n0tRoshan/Micromouse/assets/beam_vs_wall.png

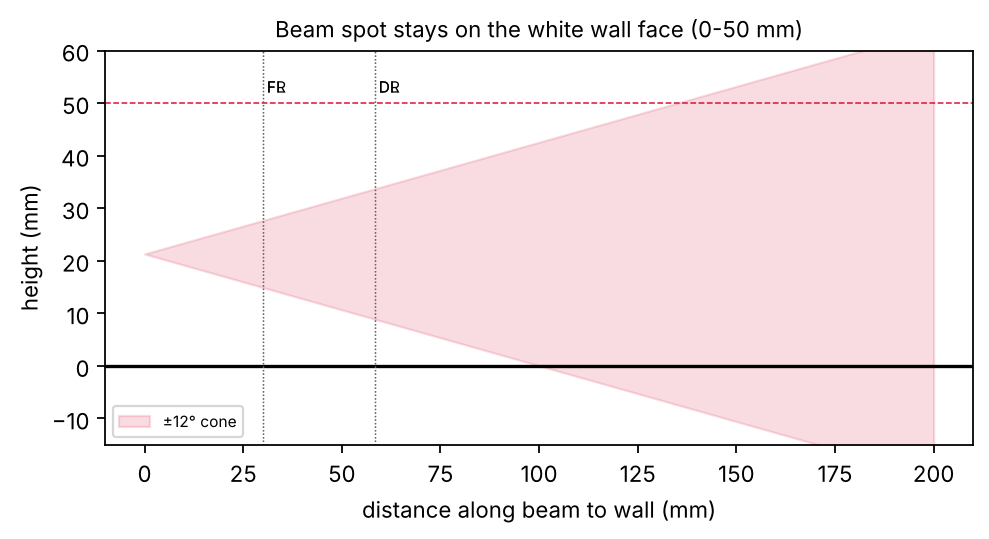
assets/beam_vs_wall.png
