n0tRoshan/Micromouse/assets/drawing_front.png

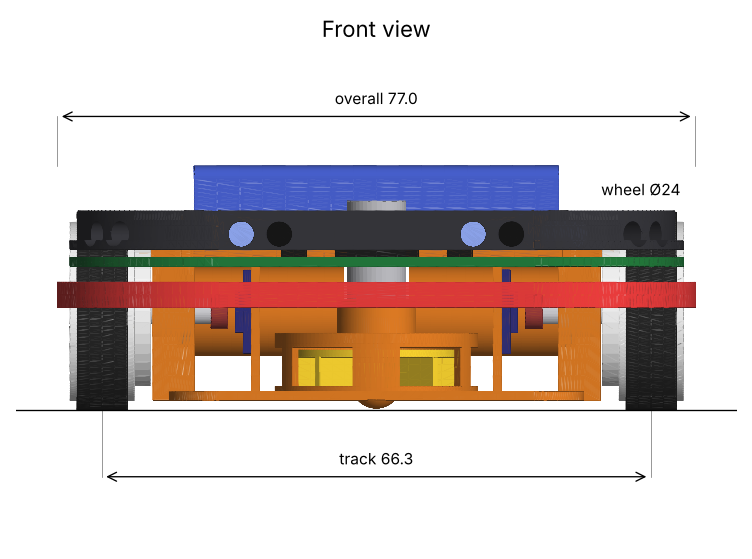
assets/drawing_front.png
