n0tRoshan/Micromouse/assets/drawing_side.png

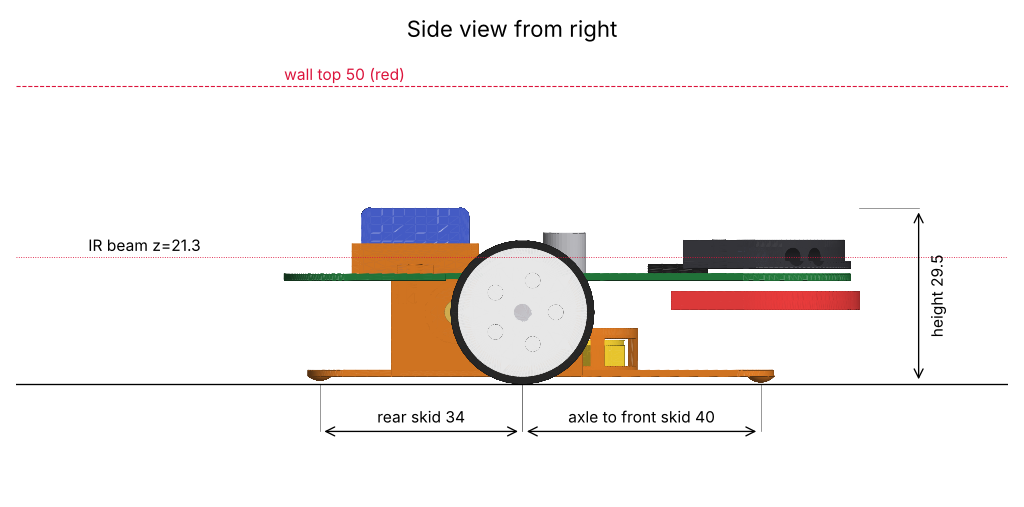
assets/drawing_side.png
