n0tRoshan/Micromouse/assets/iso_rear_right.png

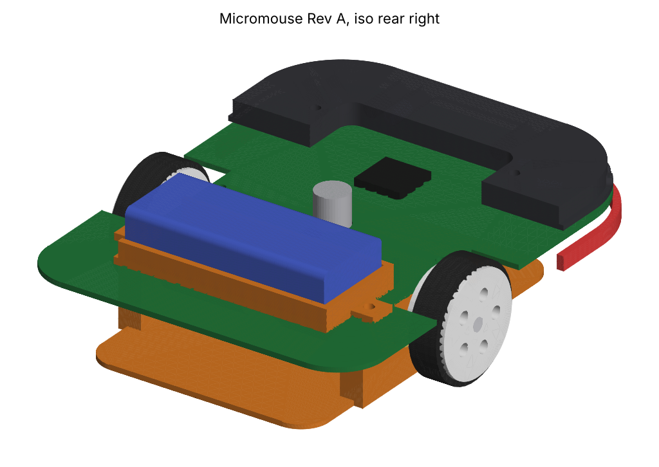
assets/iso_rear_right.png
