n0tRoshan/Micromouse/cad_design/step/micromouse_revA_assembly.step

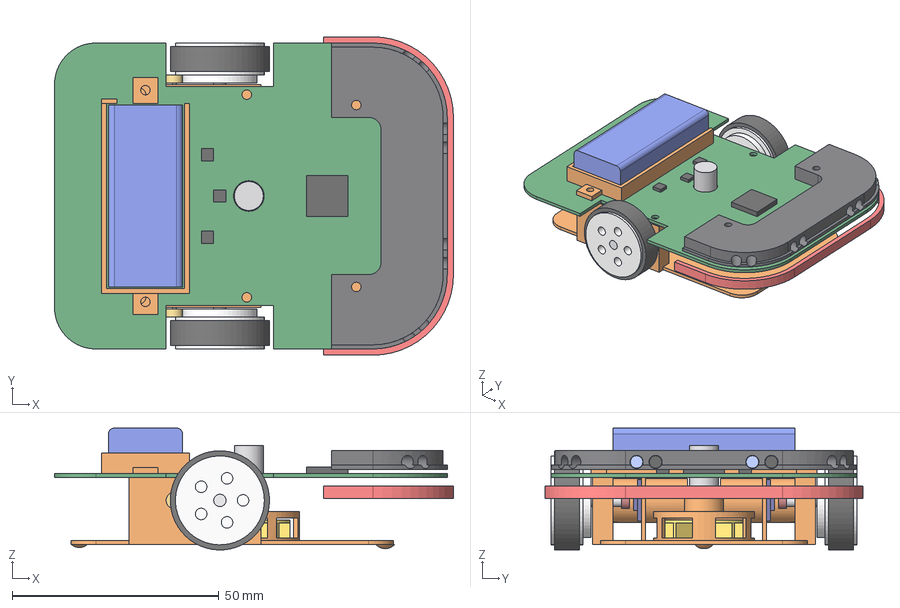
[picture p11: CAD file, 2026-10-19]
cad_design/step/micromouse_revA_assembly.step
96.5 x 77.0 x 29.5 mm
frame
plate
motor_L
pinion_L
spur_L
bearings_L
axle_L
hub_L
tire_L
magnet_L
encoder_L
motor_R
pinion_R
spur_R
bearings_R
axle_R
hub_R
tire_R
magnet_R
encoder_R
impeller
fan_motor
sensor_block
ir_emitters
ir_receivers
battery_holder
battery
bumper
mcu
imu
motor_driver
fan_mosfet
