n0tRoshan/Micromouse/cad_design/step/pinion_R.step

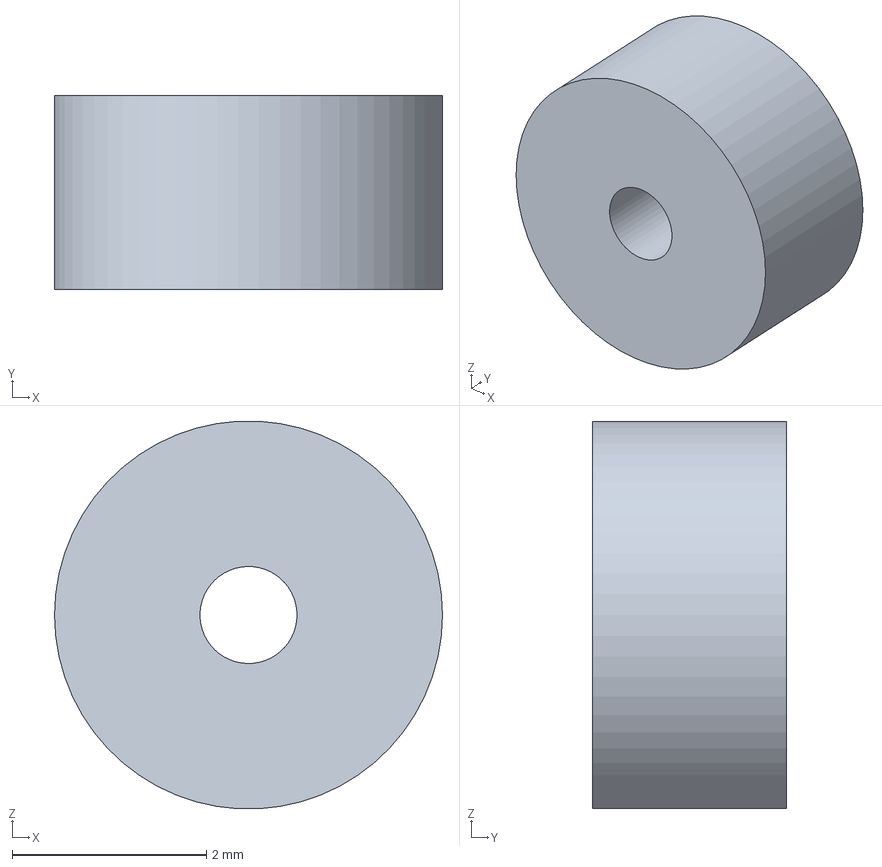
[picture p12: CAD file, 2026-10-19]
cad_design/step/pinion_R.step
4.00 x 2.00 x 3.99 mm
