n0tRoshan/Micromouse/cad_design/step/encoder_L.step

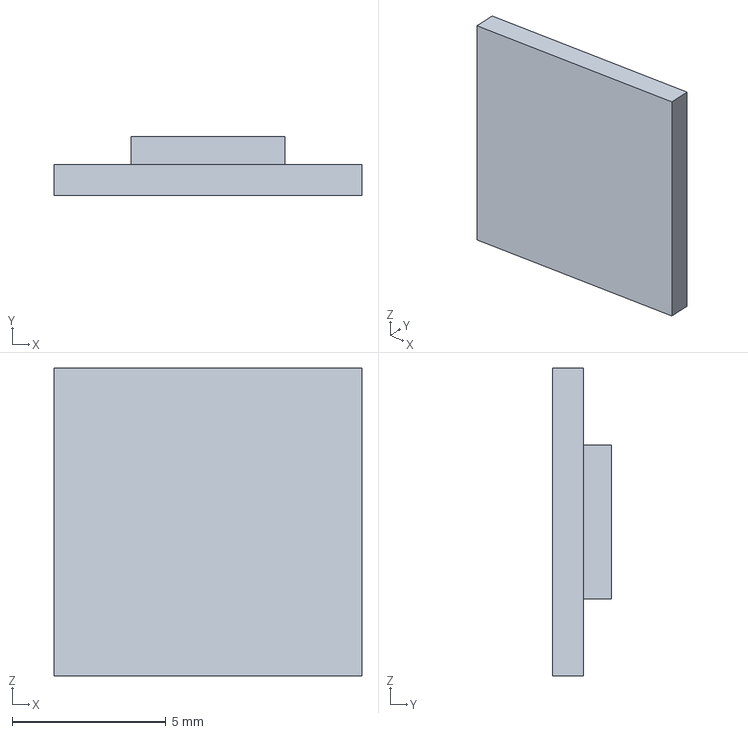
[picture p13: CAD file, 2026-10-19]
cad_design/step/encoder_L.step
10.0 x 1.90 x 10.0 mm
