n0tRoshan/Micromouse/cad_design/step/plate.step

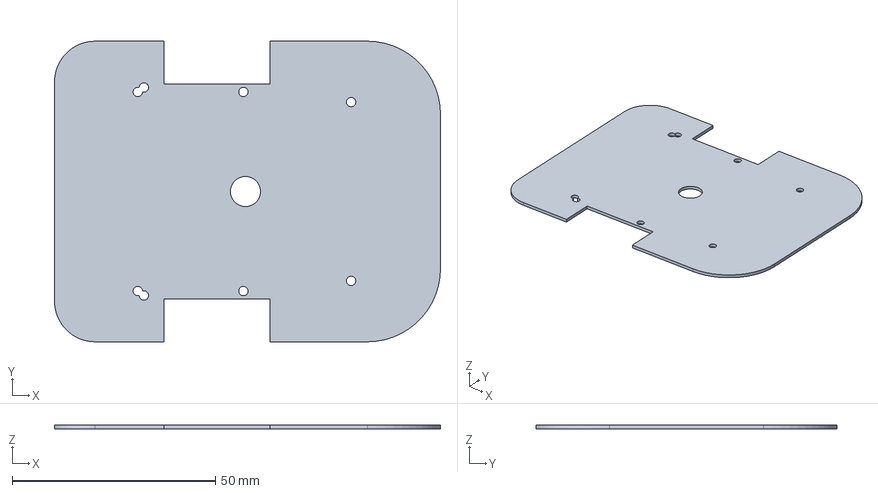
[picture p14: CAD file, 2026-10-19]
cad_design/step/plate.step
95.0 x 74.0 x 1.00 mm
