n0tRoshan/Micromouse/cad_design/step/spur_R.step

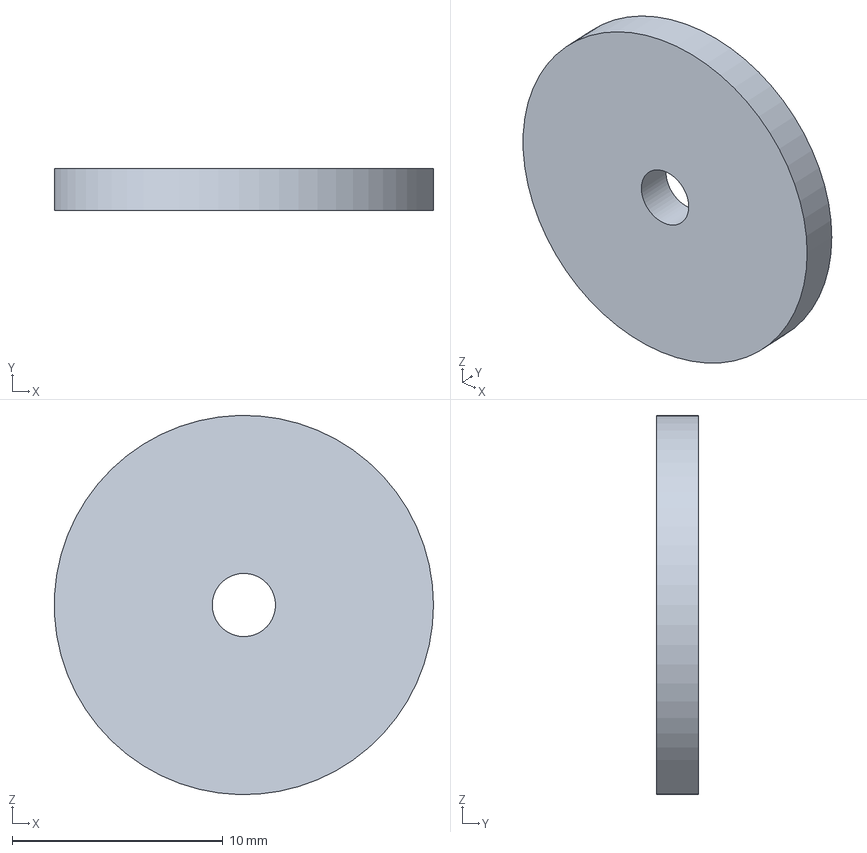
[picture p15: CAD file, 2026-10-19]
cad_design/step/spur_R.step
18.0 x 2.00 x 18.0 mm
