n0tRoshan/Micromouse/cad_design/step/mcu.step

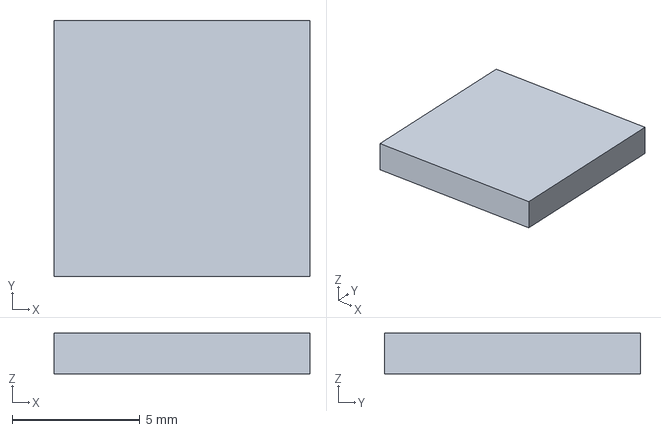
[picture p16: CAD file, 2026-10-19]
cad_design/step/mcu.step
10.0 x 10.0 x 1.60 mm
