n0tRoshan/Micromouse/cad_design/step/fan_mosfet.step

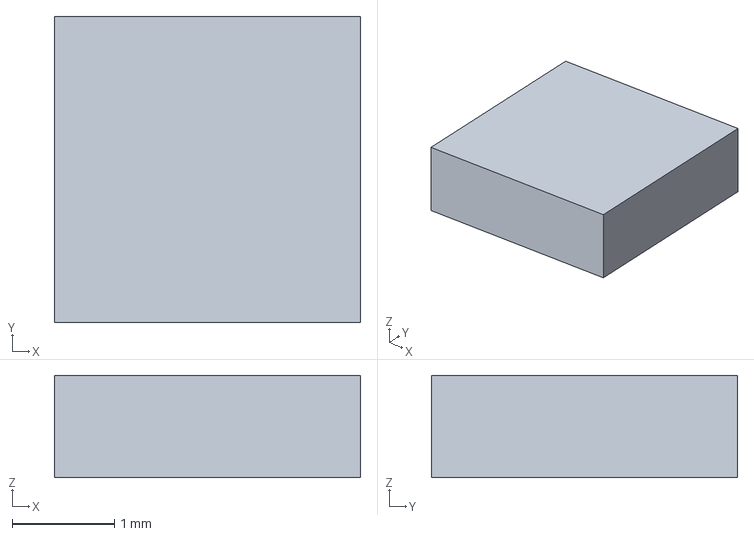
[picture p17: CAD file, 2026-10-19]
cad_design/step/fan_mosfet.step
3.00 x 3.00 x 1.00 mm
