n0tRoshan/Micromouse/cad_design/step/sensor_block.step

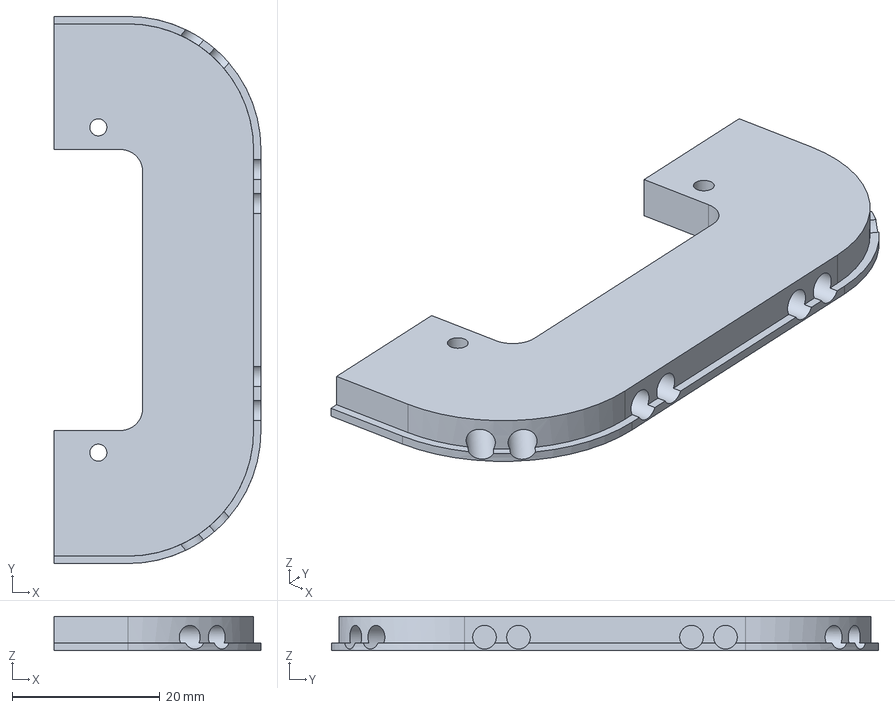
[picture p18: CAD file, 2026-10-19]
cad_design/step/sensor_block.step
28.0 x 74.0 x 4.60 mm
