n0tRoshan/Micromouse/cad_design/step/motor_L.step

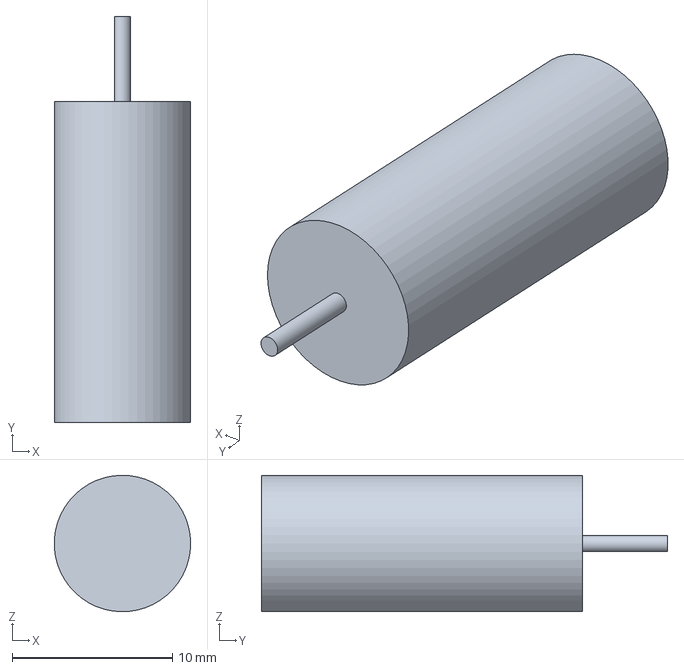
[picture p19: CAD file, 2026-10-19]
cad_design/step/motor_L.step
8.49 x 25.3 x 8.50 mm
