n0tRoshan/Micromouse/cad_design/step/fan_motor.step

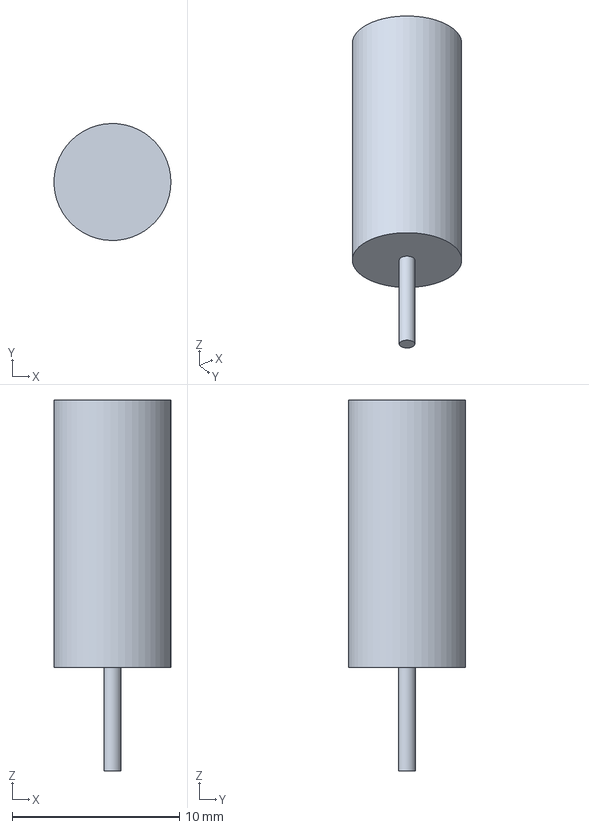
[picture p20: CAD file, 2026-10-19]
cad_design/step/fan_motor.step
6.99 x 7.00 x 22.2 mm
