n0tRoshan/Micromouse/cad_design/step/tire_L.step

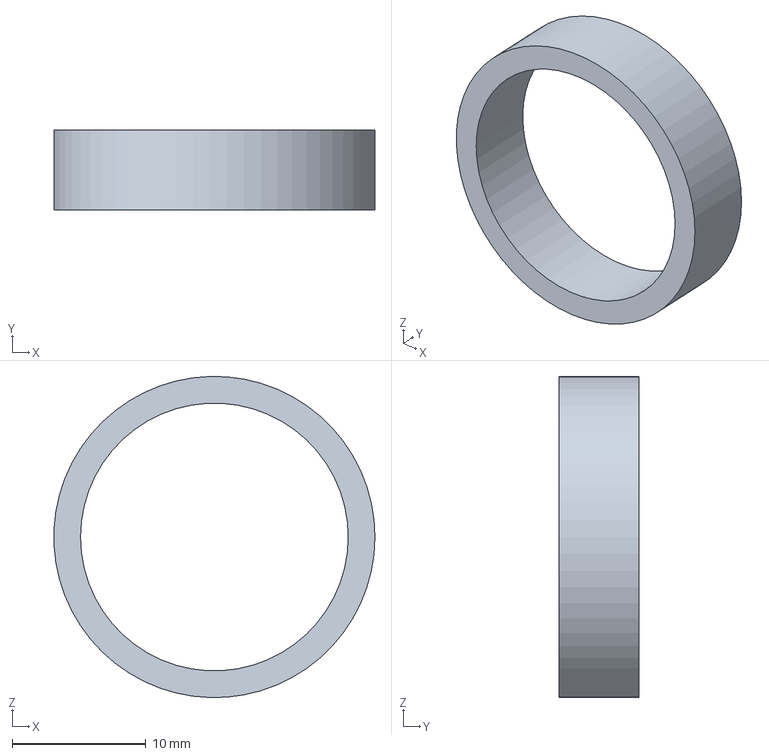
[picture p21: CAD file, 2026-10-19]
cad_design/step/tire_L.step
24.0 x 6.00 x 24.0 mm
