n0tRoshan/Micromouse/cad_design/step/bearings_L.step

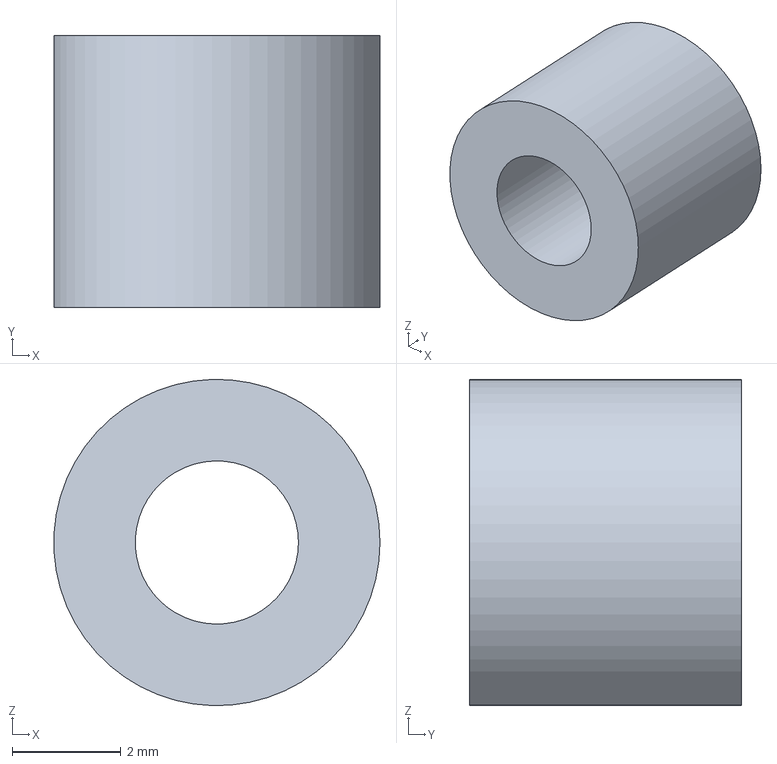
[picture p22: CAD file, 2026-10-19]
cad_design/step/bearings_L.step
6.00 x 5.00 x 6.00 mm
