n0tRoshan/Micromouse/cad_design/step/magnet_R.step

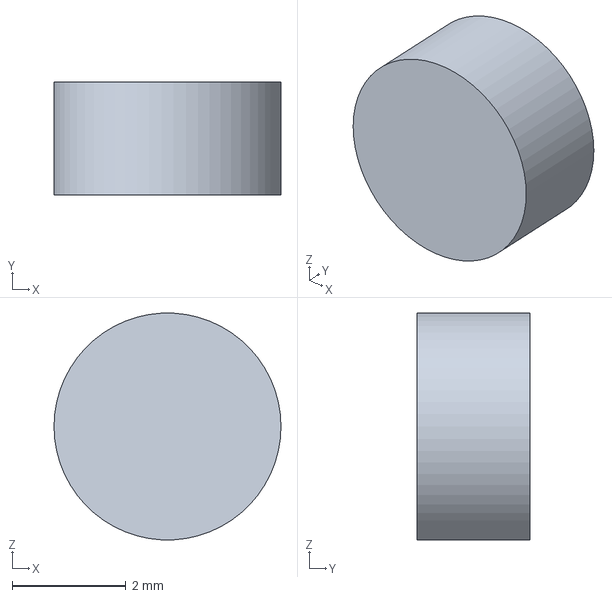
[picture p23: CAD file, 2026-10-19]
cad_design/step/magnet_R.step
4.00 x 2.00 x 3.99 mm
