n0tRoshan/Micromouse/cad_design/step/frame.step

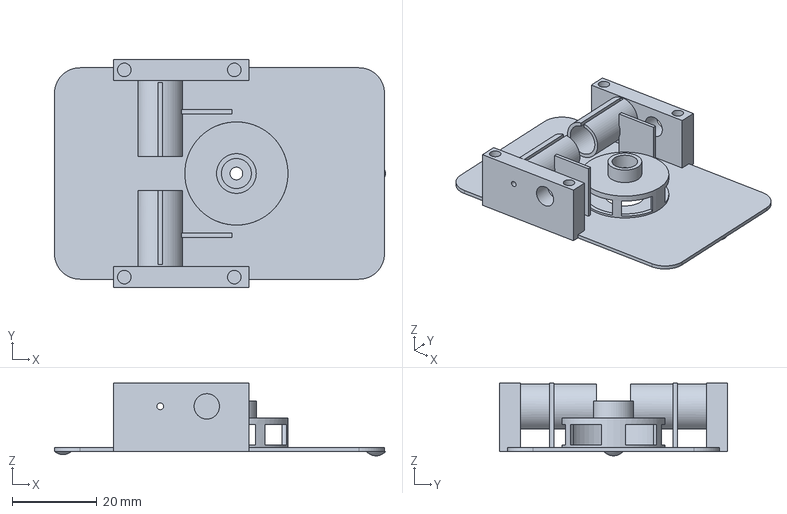
[picture p24: CAD file, 2026-10-19]
cad_design/step/frame.step
78.2 x 54.0 x 17.2 mm
