n0tRoshan/Micromouse/cad_design/step/impeller.step

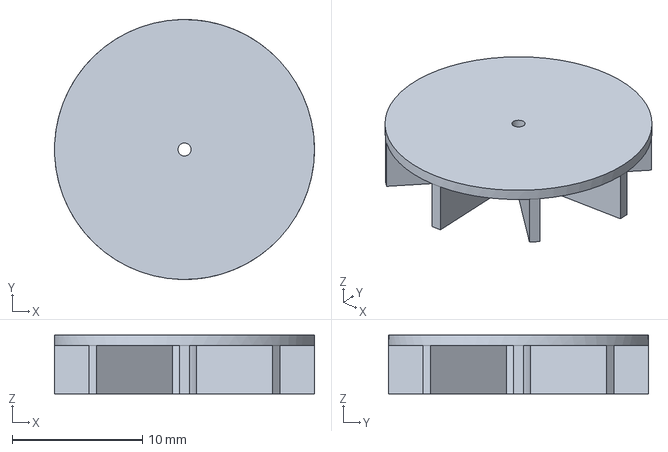
[picture p25: CAD file, 2026-10-19]
cad_design/step/impeller.step
20.0 x 20.0 x 4.50 mm
