n0tRoshan/Micromouse/cad_design/step/ir_receivers.step

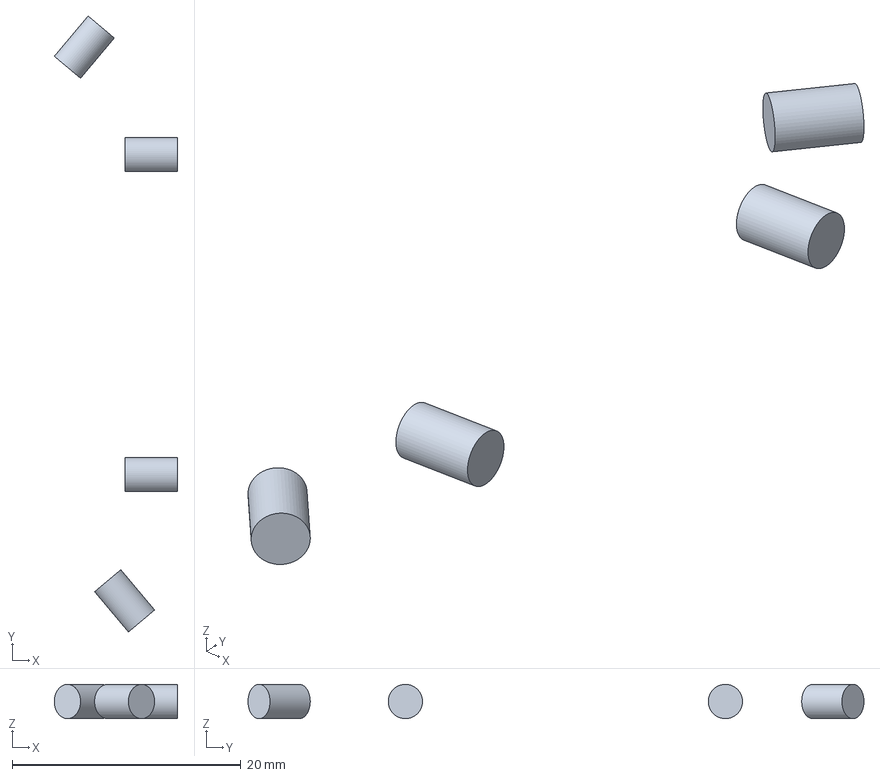
[picture p26: CAD file, 2026-10-19]
cad_design/step/ir_receivers.step
10.8 x 53.9 x 3.00 mm
