n0tRoshan/Micromouse/cad_design/step/axle_L.step

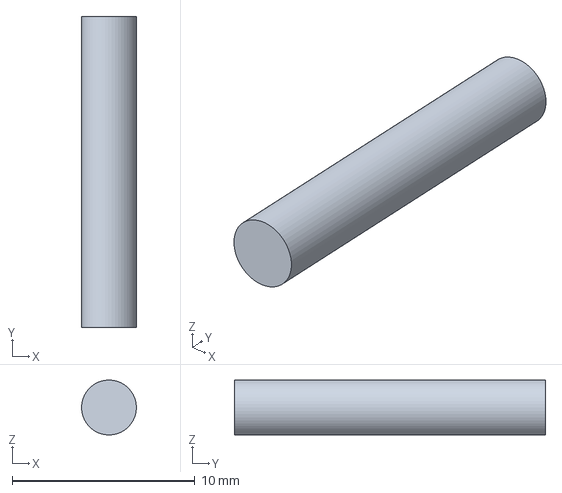
[picture p27: CAD file, 2026-10-19]
cad_design/step/axle_L.step
3.00 x 17.0 x 3.00 mm
