n0tRoshan/Micromouse/cad_design/step/hub_L.step

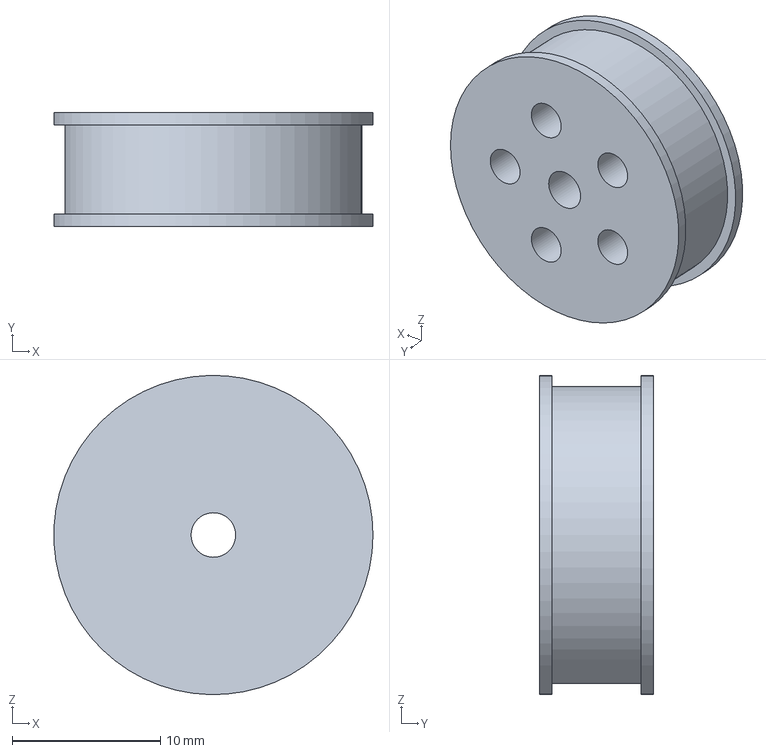
[picture p28: CAD file, 2026-10-19]
cad_design/step/hub_L.step
21.5 x 7.70 x 21.5 mm
