n0tRoshan/Micromouse/cad_design/step/battery.step

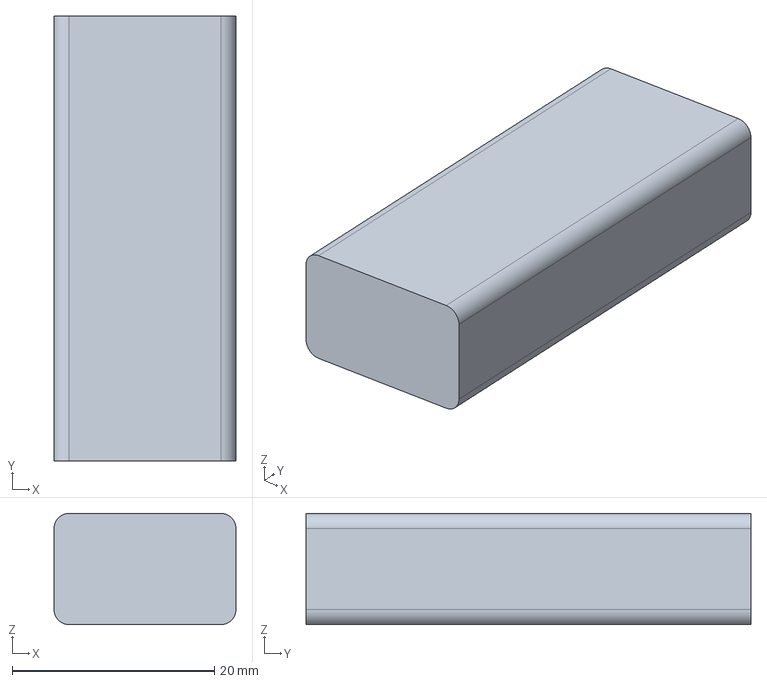
[picture p29: CAD file, 2026-10-19]
cad_design/step/battery.step
18.0 x 44.0 x 11.0 mm
