n0tRoshan/Micromouse/cad_design/step/plate_outline.dxf

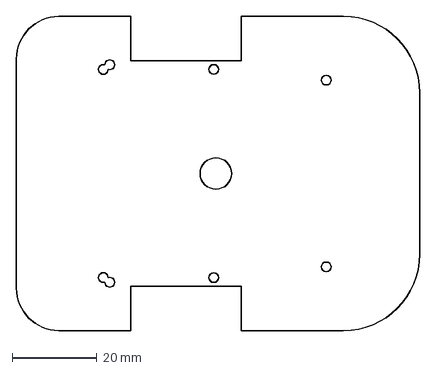
[picture p30: CAD file, 2026-10-19]
cad_design/step/plate_outline.dxf
95.0 x 74.0 mm
