n0tRoshan/Micromouse/cad_design/step/bumper.step

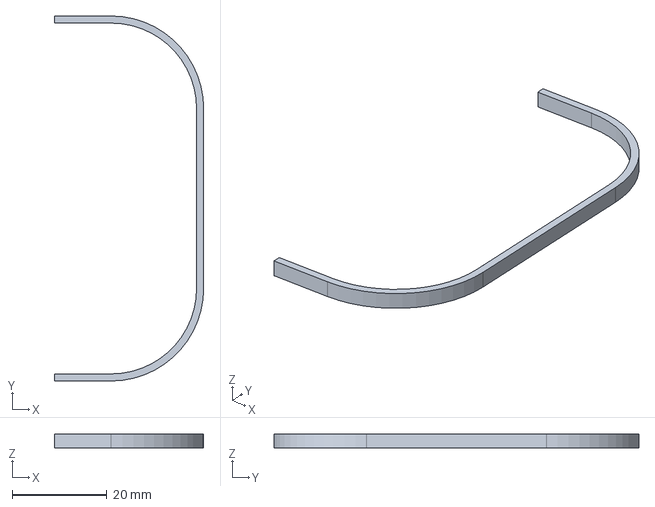
[picture p31: CAD file, 2026-10-19]
cad_design/step/bumper.step
31.5 x 77.0 x 3.00 mm
