n0tRoshan/Micromouse/cad_design/step/battery_holder.step

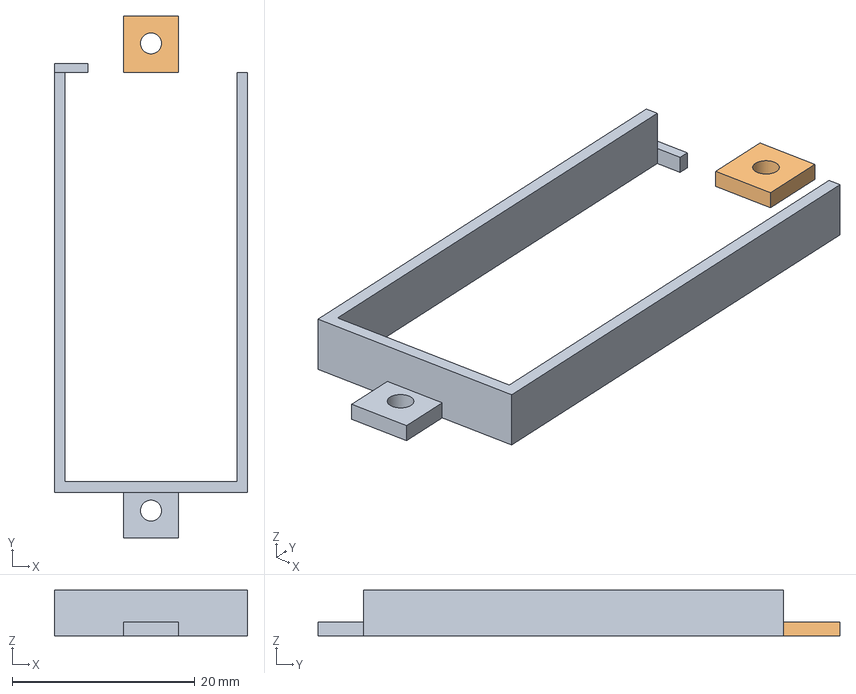
[picture p32: CAD file, 2026-10-19]
cad_design/step/battery_holder.step
21.2 x 57.2 x 5.00 mm
