n0tRoshan/Micromouse/(list of files, cad)

Other CAD files:
cad_design/step/encoder_R.step
cad_design/step/spur_L.step
cad_design/step/tire_R.step
cad_design/step/hub_R.step
cad_design/step/pinion_L.step
cad_design/step/imu.step
cad_design/step/magnet_L.step
cad_design/step/motor_driver.step
cad_design/step/motor_R.step
cad_design/step/axle_R.step
cad_design/step/bearings_R.step
cad_design/step/ir_emitters.step
cad_design/stl/battery_holder.stl
cad_design/stl/bumper.stl
cad_design/stl/frame.stl
cad_design/stl/hub_L.stl
cad_design/stl/hub_R.stl
cad_design/stl/impeller.stl
cad_design/stl/plate.stl
cad_design/stl/sensor_block.stl
